theonlydesigner/custom-rp2040/BOM.csv

Item | Qty | Supplier | Cost/item | Total Cost | link
1uF Capacitor | 1 |  | $0.10 | $0.10
0.1uF Capacitor | 1 |  | $0.10 | $0.10
10uF Capacitor | 1 |  | $0.10 | $0.10
33pF Capacitor | 1 |  | $0.20 | $0.20
USB_C_Receptacle_USB2.0_14P | 1 |  | $0.30 | $0.30
Conn_01x20 | 1 |  | $0.60 | $0.60
Conn_01x03 | 1 |  | $0.16 | $0.16
5.1K Resistor | 1 |  | $0.10 | $0.10
27 Resistor | 1 |  | $0.10 | $0.10
1K Resistor | 1 |  | $0.10 | $0.10
10K Resistor | 1 |  | $0.10 | $0.10
SW_Push | 1 |  | $0.11 | $0.11
RP2040 Chip | 1 |  | $1.30 | $1.30
MCP1700x-330xxTT | 1 |  | $0.50 | $0.50
W25Q128JVS | 1 |  | $5.02 | $5.02
12MHz Crystal | 1 |  | $0.39 | $0.39
PCB w/ Stencil | 1 |  | $10.00 | $10.00
Solder Paste | 1 |  | $3.00 | $3.00
Estimated total shipping | 1 |  |  | $0.00
