theonlydesigner/custom-rp2040/(commit log)

2026-10-26 Document KiCad design process for October 1
    Added details about the KiCad design process and included a timelapse link.
2026-10-26 Update JOURNAL.md with recent project entries
    Added detailed entries for October 1 to October 3, documenting schematic work, fixing labels, and assigning footprints.
2026-10-26 Update JOURNAL.md with PCB design progress
    Documented progress on PCB design and routing tasks over several days, including challenges faced and time spent on each task.
2026-10-26 Revise JOURNAL.md with detailed project updates
    Updated journal entries with detailed progress and time spent on various tasks related to PCB design and assembly.
2026-11-05 Add entry for November 5: Adding LEDS
    Documented the addition of an addressable LED to the board, including challenges faced during routing and ground fill issues.
